Adi1011-Data/ESP-Drone/hardware/PCB/ESCv1.0.pdf

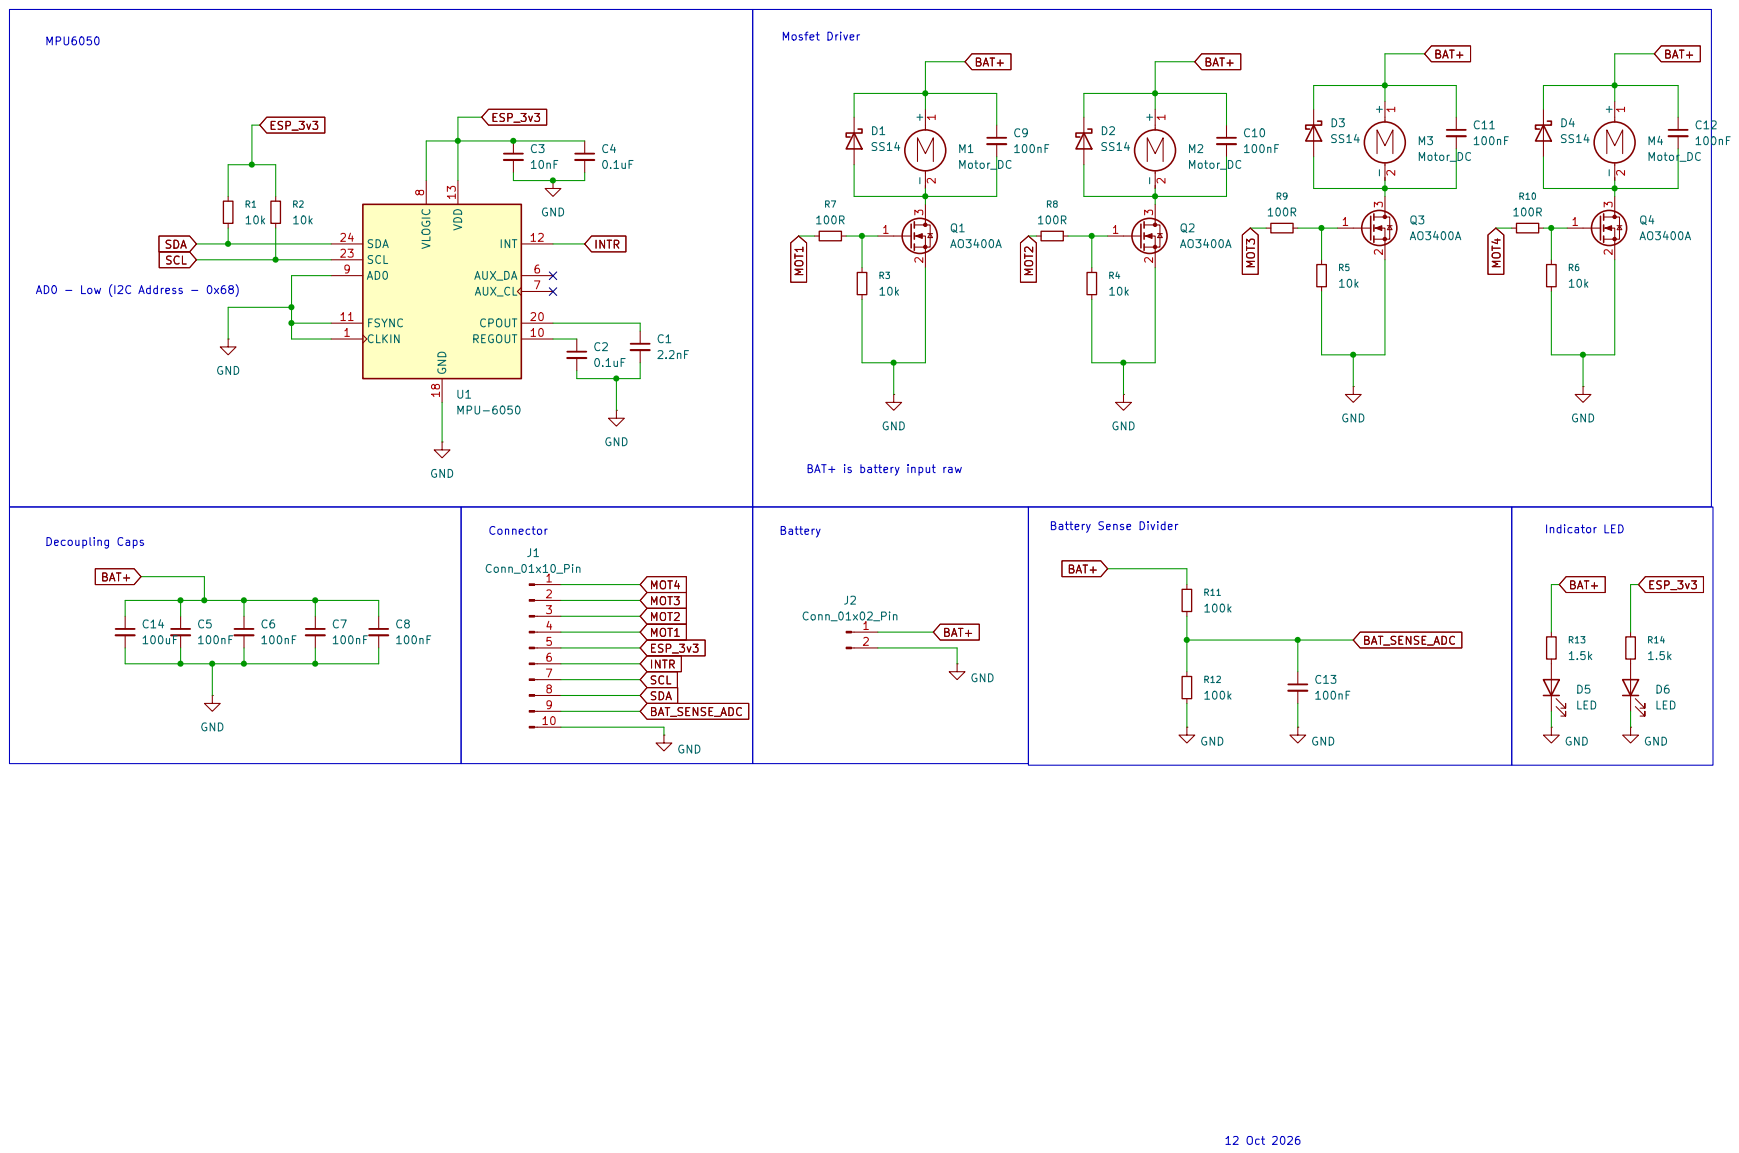
[picture p4: page 1]
