Adi1011-Data/ESP-Drone/hardware/PCB/ESC/ESCv1.pdf

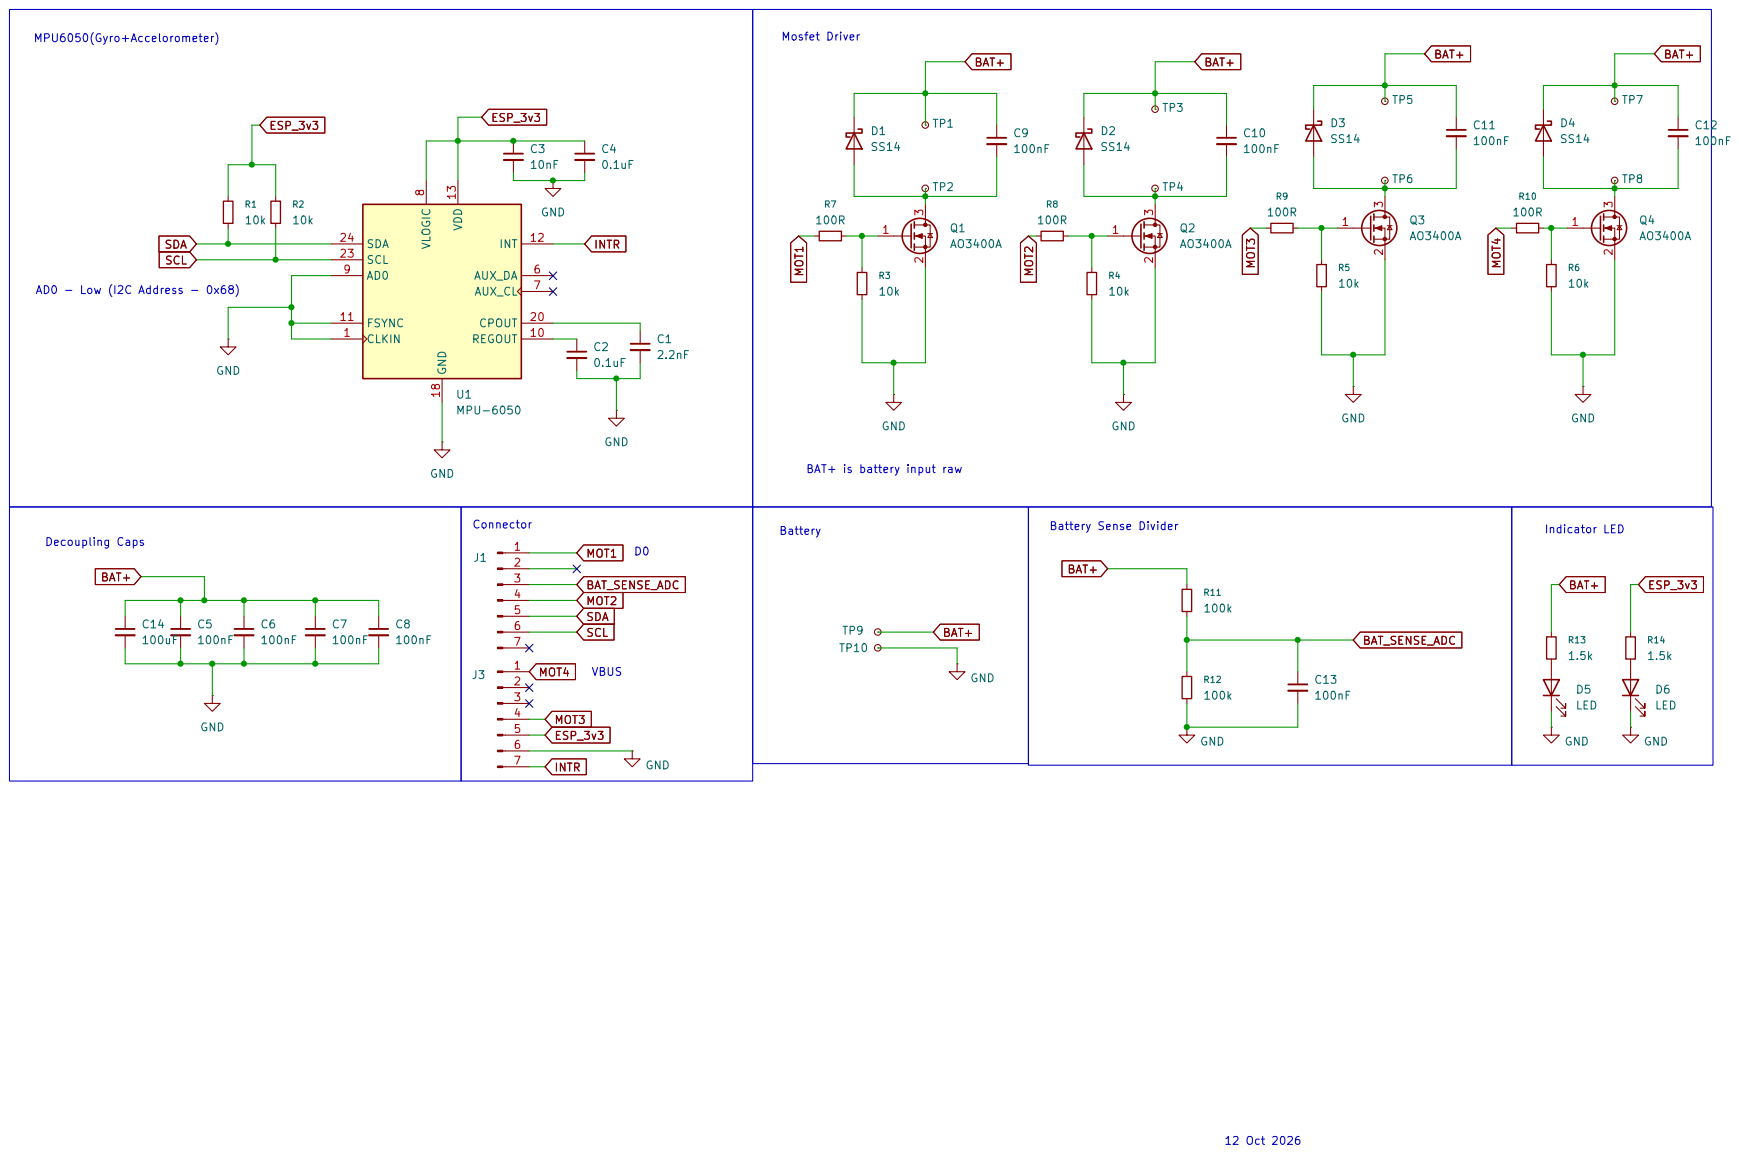
[picture p5: page 1]
