Adi1011-Data/ESP-Drone/Firmware/main/main.c

/*
 * ESP-Drone Firmware
 * 
 * Copyright 2019-2020  Espressif Systems (Shanghai) 
 * Copyright (C) 2011-2012 Bitcraze AB
 *
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
 */

#include <stdint.h>
#include <stdio.h>
#include <stdlib.h>

#include "freertos/FreeRTOS.h"
#include "freertos/task.h"
#include "freertos/portmacro.h"
#include "nvs_flash.h"

#include "stm32_legacy.h"
#include "platform.h"
#include "system.h"
#include "motors.h"
#define DEBUG_MODULE "APP_MAIN"
#include "debug_cf.h"

void app_main()
{
    /*
    * Initialize the platform and Launch the system task
    * app_main will initialize and start everything
    */

    /* Gates are pulled up, so hold every motor off before anything else. */
    motorsHoldOff();

    /* initialize nvs flash prepare for Wi-Fi */
    esp_err_t ret = nvs_flash_init();

    if (ret == ESP_ERR_NVS_NO_FREE_PAGES || ret == ESP_ERR_NVS_NEW_VERSION_FOUND) {
        ESP_ERROR_CHECK(nvs_flash_erase());
        ret = nvs_flash_init();
    }

    ESP_ERROR_CHECK(ret);

    /*Initialize the platform.*/
    if (platformInit() == false) {
        while (1);//if  firmware is running on the wrong hardware, Halt
    }

    /*launch the system task */
    systemLaunch();

}
