Adi1011-Data/ESP-Drone/Firmware/main/src/flight/system.c

/*
 *    ||          ____  _ __
 * +------+      / __ )(_) /_______________ _____  ___
 * | 0xBC |     / __  / / __/ ___/ ___/ __ `/_  / / _ \
 * +------+    / /_/ / / /_/ /__/ /  / /_/ / / /_/  __/
 *  ||  ||    /_____/_/\__/\___/_/   \__,_/ /___/\___/
 *
 * ESP-Drone Firmware
 *
 * Copyright 2019-2020  Espressif Systems (Shanghai)
 * Copyright (C) 2011-2012 Bitcraze AB
 *
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
 * system.c - Top level module implementation
 */

#include <stdbool.h>
#include <inttypes.h>
/* FreeRtos includes */
#include "FreeRTOS.h"
#include "task.h"
#include "semphr.h"

#include "version.h"
#include "config.h"
#include "param.h"
#include "log.h"
#include "ledseq.h"
#include "adc_esp32.h"
#include "pm_esplane.h"
#include "config.h"
#include "system.h"
#include "platform.h"
//#include "storage.h"
#include "configblock.h"
#include "worker.h"
#include "freeRTOSdebug.h"
//#include "uart_syslink.h"
//#include "uart1.h"
//#include "uart2.h"
#include "wifi_esp32.h"
#include "pid_http.h"
#include "comm.h"
#include "stabilizer.h"
#include "commander.h"
#include "console.h"
#include "wifilink.h"
#include "mem.h"
//#include "proximity.h"
//#include "watchdog.h"
#include "queuemonitor.h"
#include "buzzer.h"
#include "sound.h"
#include "sysload.h"
#include "estimator_kalman.h"
//#include "deck.h"
//#include "extrx.h"
#include "app.h"
#include "motors.h"
#include "stm32_legacy.h"
#define DEBUG_MODULE "SYS"
#include "debug_cf.h"
#include "static_mem.h"
//#include "peer_localization.h"
#include "cfassert.h"

#ifndef START_DISARMED
#define ARM_INIT true
#else
#define ARM_INIT false
#endif

/* Private variable */
static bool selftestPassed;
static bool canFly;
static bool armed = ARM_INIT;
static bool forceArm;
static bool isInit;

STATIC_MEM_TASK_ALLOC(systemTask, SYSTEM_TASK_STACKSIZE);

/* System wide synchronisation */
xSemaphoreHandle canStartMutex;
static StaticSemaphore_t canStartMutexBuffer;

/* Private functions */
static void systemTask(void *arg);

/* Public functions */
void systemLaunch(void)
{
  STATIC_MEM_TASK_CREATE(systemTask, systemTask, SYSTEM_TASK_NAME, NULL, SYSTEM_TASK_PRI);
}

// This must be the first module to be initialized!
void systemInit(void)
{
  if(isInit)
    return;

  DEBUG_PRINT_LOCAL("----------------------------\n");
  DEBUG_PRINT_LOCAL("%s is up and running!\n", platformConfigGetDeviceTypeName());

  canStartMutex = xSemaphoreCreateMutexStatic(&canStartMutexBuffer);
  xSemaphoreTake(canStartMutex, portMAX_DELAY);

  wifilinkInit();
  sysLoadInit();

  /* Initialized here so that DEBUG_PRINT (buffered) can be used early */
  debugInit();
  crtpInit();
  consoleInit();

  /* DEBUG_PRINT("----------------------------\n");
  DEBUG_PRINT("%s is up and running!\n", platformConfigGetDeviceTypeName());

  if (V_PRODUCTION_RELEASE) {
    DEBUG_PRINT("Production release %s\n", V_STAG);
  } else {
    DEBUG_PRINT("Build %s:%s (%s) %s\n", V_SLOCAL_REVISION,
                V_SREVISION, V_STAG, (V_MODIFIED)?"MODIFIED":"CLEAN");
  }
  DEBUG_PRINT("I am 0x%08X%08X%08X and I have %dKB of flash!\n",
              *((int*)(MCU_ID_ADDRESS+8)), *((int*)(MCU_ID_ADDRESS+4)),
              *((int*)(MCU_ID_ADDRESS+0)), *((short*)(MCU_FLASH_SIZE_ADDRESS)));*/

  configblockInit();
  //storageInit();
  workerInit();
  adcInit();
  ledseqInit();
  pmInit();
  buzzerInit();
//  peerLocalizationInit();

#ifdef APP_ENABLED
  appInit();
#endif

  isInit = true;
}

bool systemTest()
{
  bool pass=isInit;

  pass &= ledseqTest();
  pass &= pmTest();
  DEBUG_PRINTI("pmTest = %d", pass);
  pass &= workerTest();
  DEBUG_PRINTI("workerTest = %d", pass);
  pass &= buzzerTest();
  return pass;
}

/* Private functions implementation */

void systemTask(void *arg)
{
  bool pass = true;

  motorsHoldOff();
  ledInit();
  ledSet(CHG_LED, 1);
  wifiInit();
  vTaskDelay(M2T(500));

#ifdef DEBUG_QUEUE_MONITOR
  queueMonitorInit();
#endif

#ifdef ENABLE_UART1
  uart1Init(9600);
#endif
#ifdef ENABLE_UART2
  uart2Init(115200);
#endif

  //Init the high-levels modules
  systemInit();
  commInit();
  commanderInit();

  StateEstimatorType estimator = anyEstimator;
  estimatorKalmanTaskInit();
  //deckInit();
  //estimator = deckGetRequiredEstimator();
  stabilizerInit(estimator);
  pidHttpStart();
  //if (deckGetRequiredLowInterferenceRadioMode() && platformConfigPhysicalLayoutAntennasAreClose())
  //{
  //  platformSetLowInterferenceRadioMode();
  //}
  soundInit();
  memInit();

#ifdef PROXIMITY_ENABLED
  proximityInit();
#endif

	/* Test each modules */
  pass &= wifiTest();
  DEBUG_PRINTI("wifilinkTest = %d ", pass);
  pass &= systemTest();
  DEBUG_PRINTI("systemTest = %d ", pass);
  pass &= configblockTest();
  DEBUG_PRINTI("configblockTest = %d ", pass);
  //pass &= storageTest();
  pass &= commTest();
  DEBUG_PRINTI("commTest = %d ", pass);
  pass &= commanderTest();
  DEBUG_PRINTI("commanderTest = %d ", pass);
  pass &= stabilizerTest();
  DEBUG_PRINTI("stabilizerTest = %d ", pass);
  pass &= estimatorKalmanTaskTest();
  DEBUG_PRINTI("estimatorKalmanTaskTest = %d ", pass);
  //pass &= deckTest();
  //pass &= soundTest();
  //pass &= memTest();
  DEBUG_PRINTI("memTest = %d ", pass);
  //pass &= watchdogNormalStartTest();
  pass &= cfAssertNormalStartTest();
//  pass &= peerLocalizationTest();

  //Start the firmware
  if(pass)
  {
    selftestPassed = 1;
    systemStart();
    DEBUG_PRINTI("systemStart ! selftestPassed = %d", selftestPassed);
    soundSetEffect(SND_STARTUP);
    ledseqRun(&seq_alive);
    ledseqRun(&seq_testPassed);
  }
  else
  {
    selftestPassed = 0;
    if (systemTest())
    {
      while(1)
      {
        ledseqRun(&seq_testFailed);
        vTaskDelay(M2T(2000));
        // System can be forced to start by setting the param to 1 from the cfclient
        if (selftestPassed)
        {
	        DEBUG_PRINT("Start forced.\n");
          systemStart();
          break;
        }
      }
    }
    else
    {
      ledInit();
      ledSet(SYS_LED, true);
    }
  }
  DEBUG_PRINT("Free heap: %"PRIu32" bytes\n", xPortGetFreeHeapSize());

  workerLoop();

  //Should never reach this point!
  while(1)
    vTaskDelay(portMAX_DELAY);
}


/* Global system variables */
void systemStart()
{
  xSemaphoreGive(canStartMutex);
#ifndef DEBUG_EP2
  //watchdogInit();
#endif
}

void systemWaitStart(void)
{
  //This permits to guarantee that the system task is initialized before other
  //tasks waits for the start event.
  while(!isInit)
    vTaskDelay(2);

  xSemaphoreTake(canStartMutex, portMAX_DELAY);
  xSemaphoreGive(canStartMutex);
}

void systemSetCanFly(bool val)
{
  canFly = val;
}

bool systemCanFly(void)
{
  return canFly;
}

void systemSetArmed(bool val)
{
  armed = val;
}

bool systemIsArmed()
{

  return armed || forceArm;
}
// void vApplicationIdleHook( void )
// {
//   static uint32_t tickOfLatestWatchdogReset = M2T(0);

//   portTickType tickCount = xTaskGetTickCount();

//   if (tickCount - tickOfLatestWatchdogReset > M2T(WATCHDOG_RESET_PERIOD_MS))
//   {
//     tickOfLatestWatchdogReset = tickCount;
//     watchdogReset();
//   }

//   // Enter sleep mode. Does not work when debugging chip with SWD.
//   // Currently saves about 20mA STM32F405 current consumption (~30%).
// #ifndef DEBUG
//   { __asm volatile ("wfi"); }
// #endif
// }

/*System parameters (mostly for test, should be removed from here) */
/*PARAM_GROUP_START(cpu)
PARAM_ADD(PARAM_UINT16 | PARAM_RONLY, flash, MCU_FLASH_SIZE_ADDRESS)
PARAM_ADD(PARAM_UINT32 | PARAM_RONLY, id0, MCU_ID_ADDRESS+0)
PARAM_ADD(PARAM_UINT32 | PARAM_RONLY, id1, MCU_ID_ADDRESS+4)
PARAM_ADD(PARAM_UINT32 | PARAM_RONLY, id2, MCU_ID_ADDRESS+8)
PARAM_GROUP_STOP(cpu)*/

PARAM_GROUP_START(system)
PARAM_ADD(PARAM_INT8 | PARAM_RONLY, selftestPassed, &selftestPassed)
PARAM_ADD(PARAM_INT8, forceArm, &forceArm)
PARAM_GROUP_STOP(sytem)

/* Loggable variables */
LOG_GROUP_START(sys)
LOG_ADD(LOG_INT8, canfly, &canFly)
LOG_ADD(LOG_INT8, armed, &armed)
LOG_GROUP_STOP(sys)
