Adi1011-Data/ESP-Drone/Firmware/main/src/board/platform.c

/**
 *
 * ESP-Drone Firmware
 *
 * Copyright 2019-2020  Espressif Systems (Shanghai)
 * Copyright (C) 2011-2018 Bitcraze AB
 *
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
 * Generic platform functionality
 *
 */

#include <string.h>

#include "platform.h"
#include "motors.h"
#define DEBUG_MODULE "PLATFORM"
#include "debug_cf.h"

static const platformConfig_t *active_config = 0;

int platformInit(void)
{
    motorsHoldOff();

    /*platform layer used to support different hardware configuration
    * get plantform type from memory and
    * Initilizes all platform related things
    * */

    int nrOfConfigs ;
    const platformConfig_t *configs = platformGetListOfConfigurations(&nrOfConfigs);

    /*init platform configuration, copy the configuration index to active_config */
    int err = platformInitConfiguration(configs, nrOfConfigs);

    if (err != 0) {
        DEBUG_PRINT_LOCAL("This firmware is not compatible, abort init") ;
        return false;
    }

    return platformInitHardware();
}

int platformParseDeviceTypeString(const char *deviceTypeString, char *deviceType)
{
    if (deviceTypeString[0] != '0' || deviceTypeString[1] != ';') {
        return 1;
    }

    const int start = 2;
    const int last = start + PLATFORM_DEVICE_TYPE_MAX_LEN - 1;
    int end = 0;

    for (end = start; end <= last; end++) {
        if (deviceTypeString[end] == '\0' || deviceTypeString[end] == ';') {
            break;
        }
    }

    if (end > last) {
        return 1;
    }

    int length = end - start;
    memcpy(deviceType, &deviceTypeString[start], length);
    deviceType[length] = '\0';
    return 0;
}

int platformInitConfiguration(const platformConfig_t *configs, const int nrOfConfigs)
{
#ifndef DEVICE_TYPE_STRING_FORCE
    char deviceTypeString[PLATFORM_DEVICE_TYPE_STRING_MAX_LEN];
    char deviceType[PLATFORM_DEVICE_TYPE_MAX_LEN];
    platformGetDeviceTypeString(deviceTypeString);  //"0;EP20"
    platformParseDeviceTypeString(deviceTypeString, deviceType); //deviceType="EP20"
#else
#define xstr(s) str(s)
#define str(s) #s
    char *deviceType = xstr(DEVICE_TYPE_STRING_FORCE);
#endif

    for (int i = 0; i < nrOfConfigs; i++) {
        const platformConfig_t *config = &configs[i];

        if (strcmp(config->deviceType, deviceType) == 0) {
            active_config = config;
            DEBUG_PRINT_LOCAL("set active config ") ;
            return 0;
        }
    }

    return 1;
}

const char *platformConfigGetDeviceType()
{
    return active_config->deviceType;
}

const char *platformConfigGetDeviceTypeName()
{
    return active_config->deviceTypeName;
}

SensorImplementation_t platformConfigGetSensorImplementation()
{
    return active_config->sensorImplementation;
}

bool platformConfigPhysicalLayoutAntennasAreClose()
{
    return active_config->physicalLayoutAntennasAreClose;
}

const MotorPerifDef **platformConfigGetMotorMapping()
{
    return active_config->motorMap;
}
