Adi1011-Data/ESP-Drone/Firmware/main/src/power/adc_esp32.c

/**
 * ESP-Drone Firmware
 *
 * Copyright 2019-2020  Espressif Systems (Shanghai)
 * Copyright (C) 2011-2012 Bitcraze AB
 *
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
 * adc.c - Analog Digital Conversion
 *
 *
 */

#include "esp_idf_version.h"
#include "driver/adc.h"
#include "esp_adc_cal.h"
#include "adc_esp32.h"
#include "config.h"
#include "pm_esplane.h"
#include "stm32_legacy.h"
#define DEBUG_MODULE "ADC"
#include "debug_cf.h"

static bool isInit;

static esp_adc_cal_characteristics_t *adc_chars;
#ifdef CONFIG_IDF_TARGET_ESP32
static const adc_channel_t channel = ADC_CHANNEL_7; //GPIO35 if ADC1
#elif defined(CONFIG_IDF_TARGET_ESP32C3)
static const adc_channel_t channel = (adc_channel_t)DRONE_VBAT_ADC_CHANNEL; // GPIO4 = ADC1_CH4
#elif defined(CONFIG_IDF_TARGET_ESP32S2) || defined(CONFIG_IDF_TARGET_ESP32S3)
static const adc_channel_t channel = ADC_CHANNEL_1;     // GPIO2 if ADC1
#else
static const adc_channel_t channel = (adc_channel_t)DRONE_VBAT_ADC_CHANNEL;
#endif

#if defined(CONFIG_IDF_TARGET_ESP32C3)
static const adc_bits_width_t width = ADC_WIDTH_BIT_12;
#else
static const adc_bits_width_t width = ADC_WIDTH_MAX-1;
#endif
static const adc_atten_t atten = ADC_ATTEN_DB_11;   //11dB attenuation (ADC_ATTEN_DB_11) gives full-scale voltage 3.9V
static const adc_unit_t unit = ADC_UNIT_1;
#define DEFAULT_VREF 1100 //Use adc2_vref_to_gpio() to obtain a better estimate
#define NO_OF_SAMPLES   30          //Multisampling

static void print_char_val_type(esp_adc_cal_value_t val_type)
{
    if (val_type == ESP_ADC_CAL_VAL_EFUSE_TP) {
        printf("Characterized using Two Point Value\n");
    } else if (val_type == ESP_ADC_CAL_VAL_EFUSE_VREF) {
        printf("Characterized using eFuse Vref\n");
    } else {
        printf("Characterized using Default Vref\n");
    }
}

float analogReadVoltage(uint32_t pin)
{
    uint32_t adc_reading = 0;
    for (int i = 0; i < NO_OF_SAMPLES; i++) {
        if (unit == ADC_UNIT_1) {
            adc_reading += adc1_get_raw((adc1_channel_t)channel);
        } else {
            int raw;
            adc2_get_raw((adc2_channel_t)channel, width, &raw);
            adc_reading += raw;
        }
    }
    adc_reading /= NO_OF_SAMPLES;
    //Convert adc_reading to voltage in mV
    uint32_t voltage = esp_adc_cal_raw_to_voltage(adc_reading, adc_chars);
    return voltage / 1000.0;
}

void adcInit(void)
{
    if (isInit) {
        return;
    }

    if (unit == ADC_UNIT_1) {
#if !defined(CONFIG_IDF_TARGET_ESP32C3)
        adc1_config_width(width);
#endif
        adc1_config_channel_atten(channel, atten);
    } else {
        adc2_config_channel_atten((adc2_channel_t)channel, atten);
    }

    //Characterize ADC
    adc_chars = calloc(1, sizeof(esp_adc_cal_characteristics_t));
    esp_adc_cal_value_t val_type = esp_adc_cal_characterize(unit, atten, width, DEFAULT_VREF, adc_chars);
    print_char_val_type(val_type);

    isInit = true;
}

bool adcTest(void)
{
    return isInit;
}
