Adi1011-Data/ESP-Drone/(commit log)

2026-10-20 Initial import of the ESP-FLY flight stack for the XIAO ESP32-C3.
    Includes firmware, the ESC board design, and the simulation tools so the project can be built from this repository.
    [ESC-BOM.csv, ESC-ESP32.step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]
2026-10-20 Document that the local pages need serve.ps1 and work with the ESP off.
    The drone address stays the one that only opens when the board is powered and the laptop is on its Wi-Fi.
