Adi1011-Data/ESP-Drone/(notices)

Notices in the files:
Firmware/main/src/board/led_esp32.c:
This program is free software: you can redistribute it and/or modify
it under the terms of the GNU General Public License as published by
the Free Software Foundation, in version 3.
